condo4/knxboard/KnxBoard.kicad_pcb

## KiCad design KnxBoard.kicad_pcb (2026-09-16)

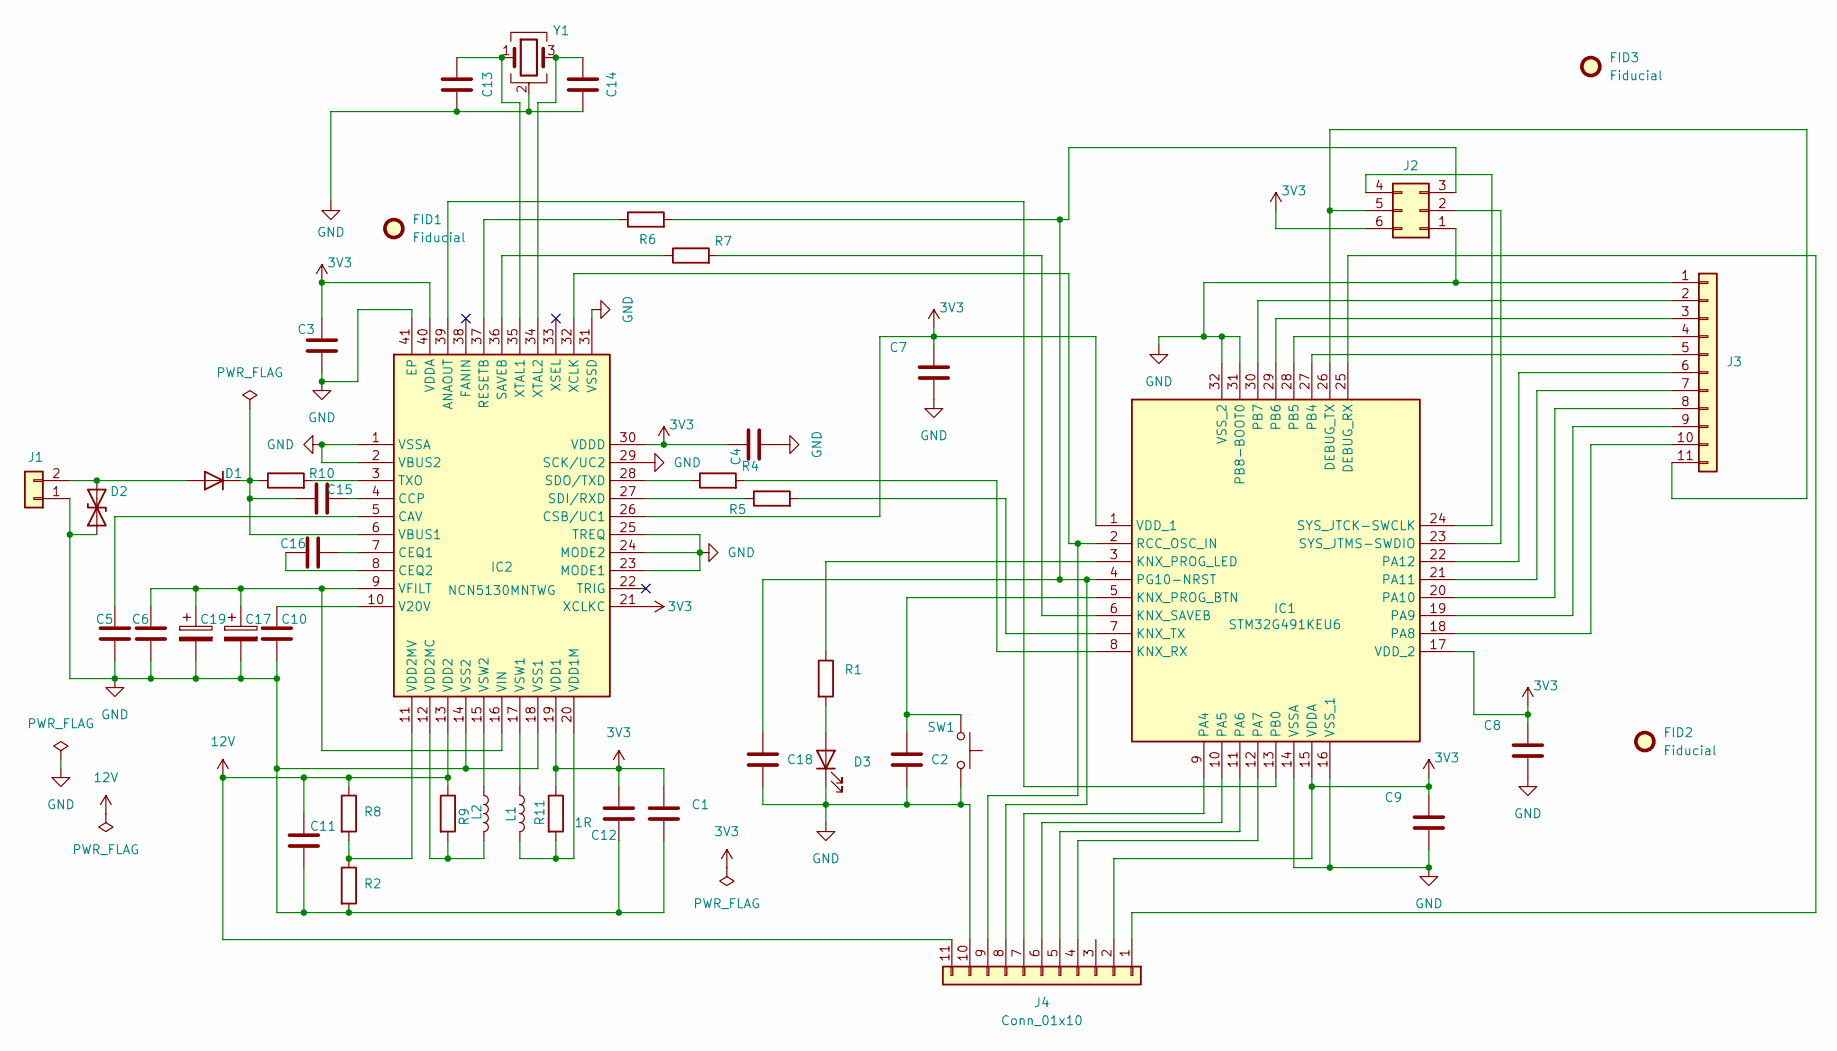
[picture p1: schematic KnxBoard.kicad_sch]

Parts:
C1, C2, C3, C4, C5, C6, C7, C8, C9, C18: 0.1 uF 50 VDC 5% 0402 X7S; C_0402_1005Metric; Mouser Part Number 81-GRM155C71H104JE9D
C10: 1 uF 100 VDC 10% 0805 X7S; C_0805_2012Metric; Mouser Part Number 81-GRJ21BC72A105KE1L
C11: 22 uF 25 VDC 0805 X5R; C_0805_2012Metric; Mouser Part Number 81-GRM21BC71C106KE1K
C12: 10 uF 16 VDC 10% 0805 X7S; C_0805_2012Metric; Mouser Part Number 81-GRM21BC71C106KE1K
C13, C14: 10 pF 50 VDC 5% 0402 C0G; C_0402_1005Metric; Mouser Part Number 81-GRM1555C1H100JA01D
C15: 0.047 uF 50 VDC 5% 0402 X7S; C_0402_1005Metric; Mouser Part Number 81-GRM155C71H473JE9D
C16: 0.22 uF 50 VDC 10% 0805 X7R; C_0805_2012Metric; Mouser Part Number 81-GCM21BR71H224KA7K
C17, C19: 100uF 35 Volt; CP_Elec_6.3x7.7; Mouser Part Number 661-EMZA350A101MF80S
D1: SS16T3G; D_SMA; Mouser Part Number 863-SS16T3G
D2: SMAJ40CA; D_SMA; Mouser Part Number 652-SMAJ40CA
D3: LED; LED_0603_1608Metric; Mouser Part Number 710-150060RS55040
FID1, FID2, FID3: Fiducial; Fiducial_1mm_Mask2mm
IC1: STM32G491KEU6; UQFN-32_5x5mm_P0.5mm; Mouser Part Number 511-STM32G491KEU6
IC2: NCN5130MNTWG; QFN50P600X600X100-41N; Manufacturer_Part_Number NCN5130MNTWG; Mouser Part Number 863-NCN5130MNTWG
J1: Conn_01x02; KNX_Connector
J2: Conn_02x03_Counter_Clockwise; PinHeader_2x03_P1.27mm_Vertical
J3, J4: Conn_01x10; PinHeader_1x11_P2.54mm_Vertical
L1, L2: 220 uH 0.4A; L_1008_2520Metric; Mouser Part Number 963-LB2518T221M
R1: 100; R_0402_1005Metric; Mouser Part Number 594-MCS04020C1000FE0
R2: 20k; R_0402_1005Metric; Mouser Part Number 594-MCS04020C2002FE0
R4, R5, R6, R7: 0; R_0402_1005Metric; Mouser Part Number 594-MCS04020Z0000ZE0
R8: 180k; R_0402_1005Metric; Mouser Part Number 594-MCS04020C1803FE0
R9, R11: 1R; R_0402_1005Metric; Mouser Part Number 594-MCS0402MC1008FE5
R10: 27 1W; R_2512_6332Metric; Mouser Part Number 660-WK73R2BTTD27R0F
SW1: SW_Push; SW_SPST_SKQG_WithStem; Mouser Part Number 688-SKQGAB
Y1: 16MHz; Crystal_SMD_3225-4Pin_3.2x2.5mm; Mouser Part Number 732-FA238-16B-K3

Connections:
3V3: C1.1, C3.1, C4.1, C7.1, C8.1, C9.1, C12.1, IC1.1 (VDD_1), IC1.15 (VDDA), IC1.17 (VDD_2), IC2.19 (VDD1), IC2.21 (XCLKC), IC2.26 (CSB/UC1), IC2.30 (VDDD), IC2.40 (VDDA), J2.6, J4.2, R11.1
12V: C11.1, IC2.13 (VDD2), J4.11, R8.1, R9.1
GND: C1.2, C2.2, C3.2, C4.2, C5.2, C6.2, C7.2, C8.2, C9.2, C10.2, C11.2, C12.2, C13.2, C14.2, C17.2, C18.2, C19.2, D2.1 (A1), D3.1 (K), IC1.14 (VSSA), IC1.16 (VSS_1), IC1.31 (PB8-BOOT0), IC1.32 (VSS_2), IC2.1 (VSSA), IC2.2 (VBUS2), IC2.14 (VSS2), IC2.18 (VSS1), IC2.23 (MODE1), IC2.24 (MODE2), IC2.25 (TREQ), IC2.29 (SCK/UC2), IC2.31 (VSSD), IC2.41 (EP), J1.1, J2.1, J3.1, J4.10, R2.2, SW1.2, Y1.2 (G), Y1.4 (G)
unnamed: D1.2 (A), D2.2 (A2), J1.2
unnamed: C15.1, D1.1 (K), IC2.6 (VBUS1), R10.1
unnamed: D3.2 (A), R1.2
unnamed: IC1.25 (DEBUG_RX), J4.1
unnamed: IC1.26 (DEBUG_TX), J2.5, J3.11
unnamed: C2.1, IC1.5 (KNX_PROG_BTN), SW1.1
unnamed: IC1.3 (KNX_PROG_LED), R1.1
unnamed: IC1.8 (KNX_RX), R4.2
unnamed: IC1.6 (KNX_SAVEB), R7.2
unnamed: IC1.7 (KNX_TX), R5.2
unnamed: IC1.9 (PA4), J4.7
unnamed: IC1.10 (PA5), J4.6
unnamed: IC1.11 (PA6), J4.5
unnamed: IC1.12 (PA7), J4.4
unnamed: IC1.18 (PA8), J3.10
unnamed: IC1.19 (PA9), J3.9
unnamed: IC1.20 (PA10), J3.8
unnamed: IC1.21 (PA11), J3.7
unnamed: IC1.22 (PA12), J3.6
unnamed: IC1.13 (PB0), IC2.39 (ANAOUT)
unnamed: IC1.27 (PB4), J3.5
unnamed: IC1.28 (PB5), J3.4
unnamed: IC1.29 (PB6), J3.3
unnamed: IC1.30 (PB7), J3.2
unnamed: C18.1, IC1.4 (PG10-NRST), J2.3, J4.8, R6.2
unnamed: IC1.2 (RCC_OSC_IN), IC2.32 (XCLK), J4.9
unnamed: IC1.24 (SYS_JTCK-SWCLK), J2.4
unnamed: IC1.23 (SYS_JTMS-SWDIO), J2.2
unnamed: C5.1, IC2.5 (CAV)
unnamed: C15.2, IC2.4 (CCP)
unnamed: C16.2, IC2.7 (CEQ1)
unnamed: C16.1, IC2.8 (CEQ2)
unnamed: IC2.37 (RESETB), R6.1
unnamed: IC2.36 (SAVEB), R7.1
unnamed: IC2.27 (SDI/RXD), R5.1
unnamed: IC2.28 (SDO/TXD), R4.1
unnamed: IC2.3 (TXO), R10.2
unnamed: C10.1, IC2.10 (V20V)
unnamed: IC2.20 (VDD1M), L1.2, R11.2
unnamed: IC2.12 (VDD2MC), L2.2, R9.2
unnamed: IC2.11 (VDD2MV), R2.1, R8.2
unnamed: C6.1, C17.1, C19.1, IC2.9 (VFILT), IC2.16 (VIN)
unnamed: IC2.17 (VSW1), L1.1
unnamed: IC2.15 (VSW2), L2.1
unnamed: C13.1, IC2.35 (XTAL1), Y1.1
unnamed: C14.1, IC2.34 (XTAL2), Y1.3

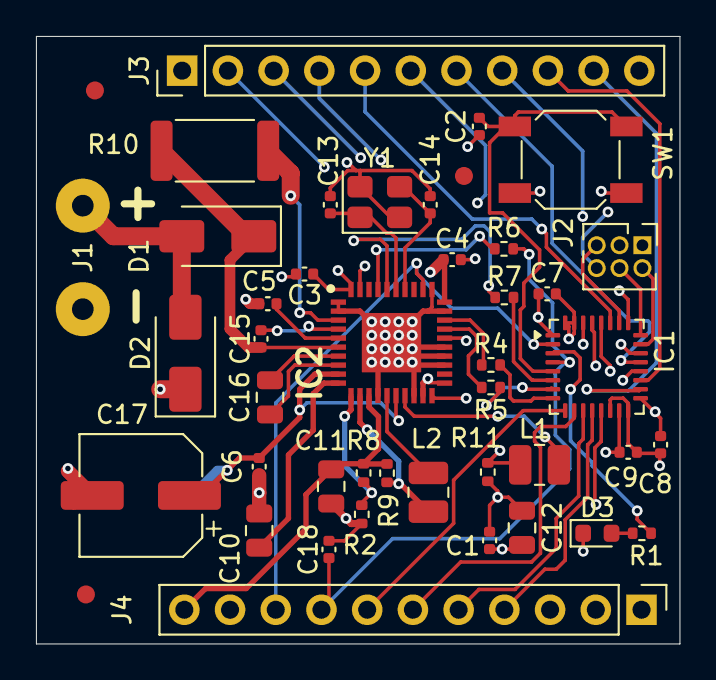
[picture p2: board KnxBoard.kicad_pcb from above]

Board: 4 copper layers, 35.8 x 33.8 mm, 45 parts (1 on the bottom side), 49 nets.
