condo4/knxboard/(commit log)

2026-06-23 Fix Error (First JLCPCB board was fail)
2026-06-24 Add GND and 3V3 plan in middle layers
2026-08-19 Add NRST and 3V3 to debug connector
    Connect ANAOUT to STM ADC to be able to support the KNX System B standard
    Update to kicad 10.0
2026-09-16 Add new capa footprint on the other side
